PRNicovich/CO2tin/Pics/holes.png

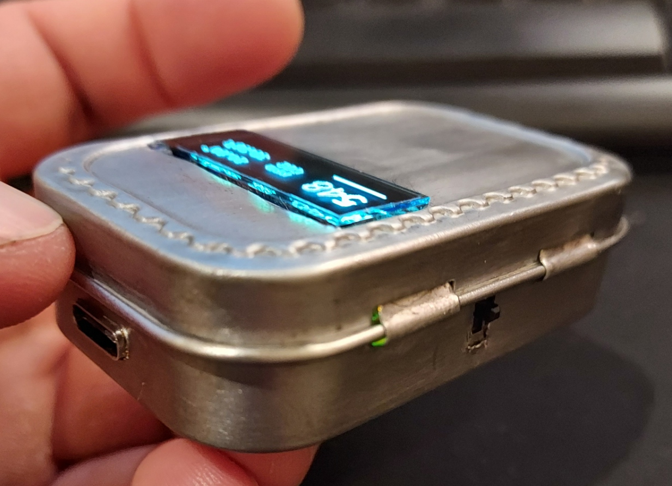
Pics/holes.png
