PRNicovich/CO2tin/Pics/TinInAction.png

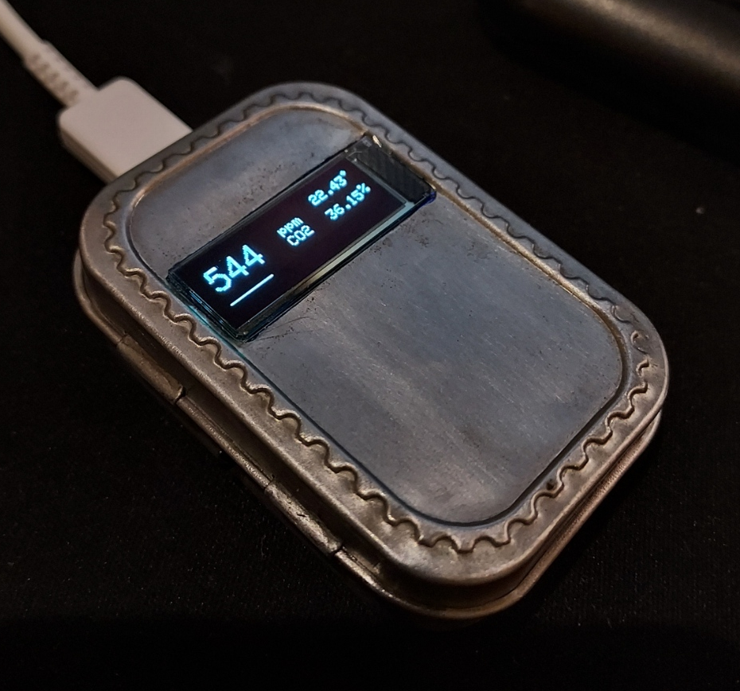
Pics/TinInAction.png
