PRNicovich/CO2tin/Pics/gutsClean.png

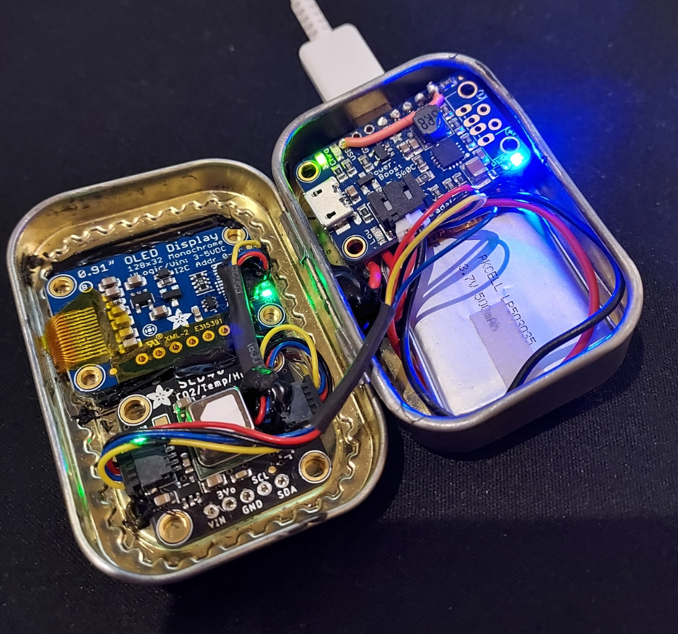
Pics/gutsClean.png
